vince-watson/person-following-robot/docs/images/sensor-mount.jpeg

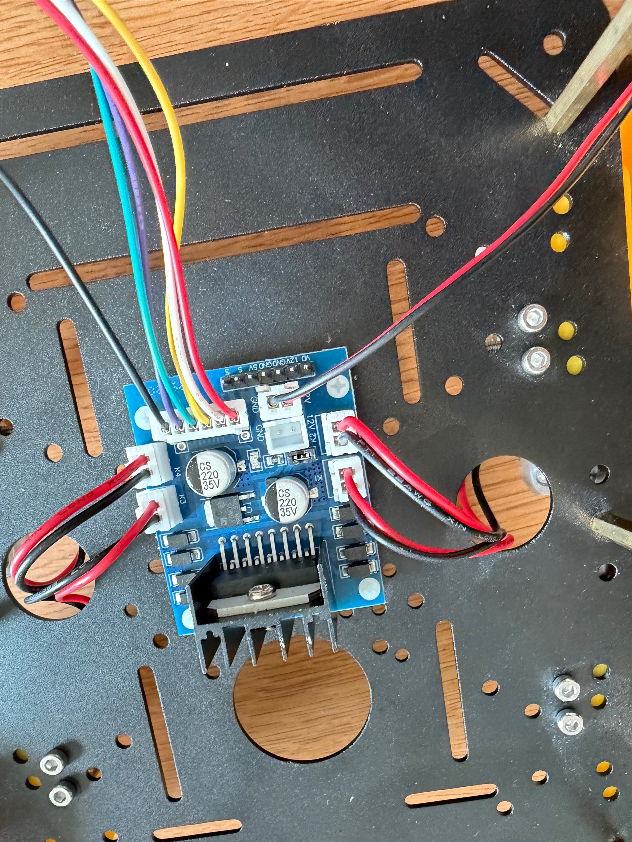
docs/images/sensor-mount.jpeg
